mertsgnms/arduino-graphical-multimeter/SystemDesign.png

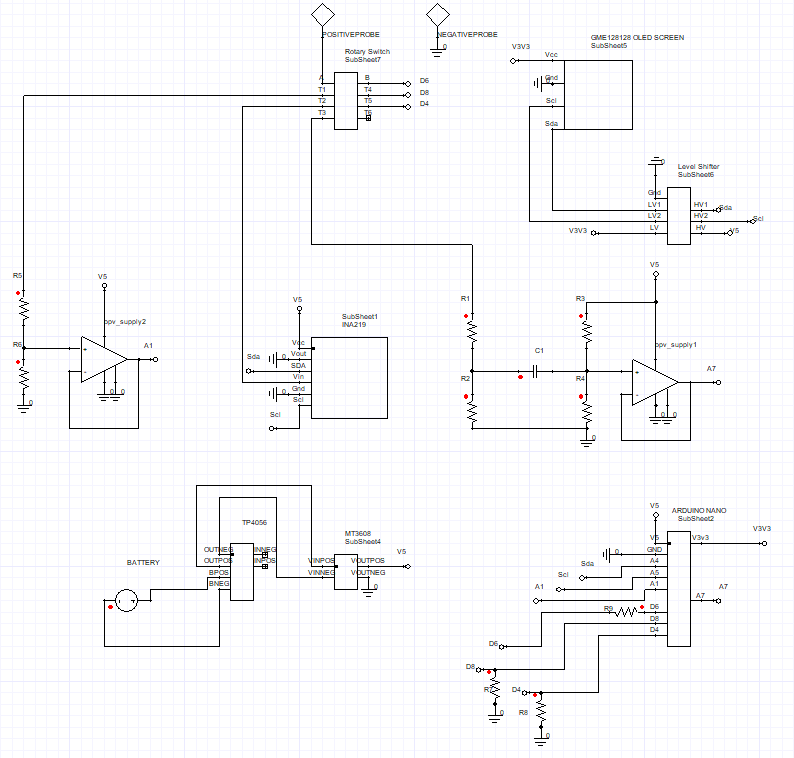
SystemDesign.png
